Thomasyijun2026/pynq-av-tracker/docs/submission.md

# 评分项目与提交材料

依据已归档的 [AMD 赛道指南](https://fpgaceshi.oss-cn-shanghai.aliyuncs.com/profoss/upload/2026/08/31/8c7a809f-f0b8-42e4-996a-3a5f2f132288.pdf)自主选题部分 3.3，以及[作品上传说明](http://www.fpgachina.cn/notice-details.html?id=58)。指南归档 SHA256 为 `c6ad82acd4f7bdcd13bd412e232ed85d05f2a87dd5e2cdd04f9d219f88b569fc`。以下对应实际材料与评分项目，权重来自指南。

| 评分项目 | 权重 | 已准备内容与阅读入口 |
|---|---:|---|
| 创新性与应用价值 | 30% | 固定阵列感知、主动相机观察及已知参考初始化；[设计报告](../report/main.pdf)第 1、2、5 章与[系统结构](architecture.md) |
| 性能与资源优化效果 | 20% | PL/PS 分工、定点 FIR 流水化、相位计算优化对照、100 MHz 实现及资源时序报告；报告第 6 章与[性能资料](performance.md) |
| 功能正确性与设计完整性 | 20% | 实机视频、初始化成功记录、完整 RTL/PS/桌面源码和整数一致性检查；[演示内容](demo_recording.md)与[验证材料](validation.md) |
| 大模型协作与技能包 | 15% | 报告第 8、9 章、[协作记录](ai_collaboration.md)及[可复用技能包](../skill/README.md) |
| 文档质量与可复现性 | 15% | 原理、接口与硬件说明、工程恢复、构建步骤、文件摘要、MIT 与第三方许可；[复现入口](reproduce.md) |

## 已提交的三份成品

| 提交项 | 成品内容 |
|---|---|
| 演示视频 | 实机硬件介绍、桌面连接、人工初始化和声音引导相机的演示；MP4 / H.264，2 分 56.7 秒，52.27 MB |
| 技术文档 PDF | 31 页，覆盖原理、系统设计、硬件与软件、优化对照、实验结果、大模型协作、技能包及复现；9.58 MB，见[已提交报告](../report/main.pdf) |
| 完整源码 RAR | 14.39 MB，包含 231 个文件；独立解包、195 份工程源文件恢复、43 项整数参考及 64 项生命周期检查通过 |

三份文件的完整名称、大小与 SHA-256 见[提交材料索引](submitted_materials.md)。它们保持提交时内容；仓库说明更新后，源码 RAR 内的说明继续保留原样。

## 开源与配套材料

公开仓库为 `Thomasyijun2026/pynq-av-tracker`，原创代码采用 MIT。RTL、PS 与桌面源码位于 `source/`，测试向量、构建脚本和验证记录分别有对应入口。原始模块名通过 `manifests/source.json` 恢复。

演示视频与源码 RAR 通过参赛平台提交，本仓库记录其身份；报告 PDF 同时收录在 `report/main.pdf`。承诺授权书、海报和作品照片属于参赛平台的独立提交项，本页的三份成品核对不包含这些附件。
