Thomasyijun2026/pynq-av-tracker/docs/submitted_materials.md

# 已提交成品索引

本页对应已经提交的演示视频、技术文档和完整源码 RAR。三份文件按提交时内容冻结；仓库首页和补充说明独立维护，程序源码保持原样。

## 文件身份

| 成品 | 文件名 | 字节数 |
|---|---|---:|
| 演示视频 | 基于PYNQ-Z2的声源定位与视觉跟随系统_作品演示.mp4 | 52,267,604 |
| 技术文档 | 《基于 PYNQ-Z2 的声源定位与视觉跟随系统》设计报告.pdf | 9,577,298 |
| 完整源码 | 基于PYNQ的声视主动追踪系统_完整源码.rar | 14,385,354 |

SHA-256：

- 演示视频：`152224e2a3f9b92de04e864be2fa3caecfbe6d6da3aff6772eec99f8a4f45fdf`
- 技术文档：`09fd8e2e0904f29d18b212dc91cfdc4d5f5d7ad80b14771ad5f54f542d042716`
- 完整源码：`c4ebf6ebd987f6c2c28c40305b97008a4b7d1c911cfa9ca440bd513375ed5842`

## 建议阅读顺序

- 先看演示视频，了解装置组成、初始化和相机朝向变化；[演示内容](demo_recording.md)提供过程索引。
- 再看[技术报告](../report/main.pdf)：第 1、2、5 章说明目标与初始化方法，第 3、4 章说明 PL/PS 分工与算法，第 6 章给出优化和资源时序，第 7 章展示实测，第 8、9 章说明协作与技能包，附录给出接口与复现方法。
- 最后通过源码 RAR 或本仓库的[复现说明](reproduce.md)恢复工程、检查源文件与重跑测试。RAR 已完成独立解包和文件级校验，并通过 43 项整数参考与 64 项运行生命周期检查。

上述记录对应本页摘要标识的成品。原始验证数据和调试批次继续保存在[验证入口](validation.md)中，测试批次之间分别记录；展示文档更新不会改写这些记录。

## 许可

公开仓库的原创源码采用 [MIT](../LICENSE)。第三方代码及工具许可单列在[第三方说明](third_party.md)。已提交报告保留原文，本仓库的实际许可由 `LICENSE` 确定。
