Thomasyijun2026/pynq-av-tracker/validation/materials/initialization_records.csv

session | request_id | sequence | action | status | total_seconds | cleanup_verified | reason_category | source_id
session_B | ui_1793778394284_6ed8f0be | 1 | initialize | INITIALIZATION_REJECTED | 15.7980650720001 | True | SCREEN_NOT_FOUND | S1
session_B | ui_1793778439002_84727a12 | 2 | initialize | RELATIVE_TARGET_CONFIRMED | 43.90765636600008 | True |  | S7
session_A | ui_1793779146720_bdaa8e16 | 1 | initialize | INITIALIZATION_REJECTED | 41.370130856 | True | AUDIO_REFERENCE_REJECTED | S3
session_A | ui_1793779194005_c66174dc | 2 | initialize | RELATIVE_TARGET_CONFIRMED | 39.062433763 | True |  | S3
session_A | ui_1793779381276_d62e0b2d | 20 | initialize | INITIALIZATION_REJECTED | 28.89297830800001 | True | STATIC_VISUAL_MODEL_REJECTED | S4
session_A | ui_1793779415342_5df36497 | 21 | initialize | RELATIVE_TARGET_CONFIRMED | 44.35287299799995 | True |  | S8
session_A | ui_1793779543464_b0b11086 | 31 | initialize | RELATIVE_TARGET_CONFIRMED | 46.404588607999926 | True |  | S8
session_A | ui_1793780359812_51714cee | 117 | initialize | RELATIVE_TARGET_CONFIRMED | 41.84338274300012 | True |  | S8
session_A | ui_1793780539784_98df1130 | 133 | initialize | RELATIVE_TARGET_CONFIRMED | 43.50091960999998 | True |  | S8
session_A | ui_1793780795257_f9b87ca1 | 158 | initialize | INITIALIZATION_REJECTED | 33.87497050899992 | True | ACTUATOR_PROTECTION | S8
session_A | ui_1793780836292_30e9c1bc | 159 | initialize | INITIALIZATION_REJECTED | 39.202294648999896 | True | AUDIO_REFERENCE_REJECTED | S8
session_A | ui_1793780892419_86b76f78 | 160 | initialize | INITIALIZATION_REJECTED | 38.332203819999904 | True | AUDIO_REFERENCE_REJECTED | S8
