Thomasyijun2026/pynq-av-tracker/source/hardware/abi5/component_coordinates_v20.csv

reference | native_x_mm | native_y_mm | from_left_edge_mm | from_bottom_edge_mm | rotation_deg | layer | footprint
C1 | -7.999999 | 13.499998 | 10.500001 | 26.999998 | 0 | TOP | 87ca9d672aa2a90f
C2 | 11.2 | 53.649999 | 29.7 | 67.149999 | 90 | TOP | 87ca9d672aa2a90f
C3 | 43.2 | 53.649999 | 61.7 | 67.149999 | 90 | TOP | 87ca9d672aa2a90f
C4 | 75.199999 | 53.649999 | 93.699999 | 67.149999 | 90 | TOP | 87ca9d672aa2a90f
C5 | 107.200001 | 53.649999 | 125.700001 | 67.149999 | 90 | TOP | 87ca9d672aa2a90f
C6 | 11.2 | 13.650001 | 29.7 | 27.150001 | 90 | TOP | 87ca9d672aa2a90f
C7 | 43.2 | 13.650001 | 61.7 | 27.150001 | 90 | TOP | 87ca9d672aa2a90f
C8 | 75.199999 | 13.650001 | 93.699999 | 27.150001 | 90 | TOP | 87ca9d672aa2a90f
C9 | 107.200001 | 13.650001 | 125.700001 | 27.150001 | 90 | TOP | 87ca9d672aa2a90f
J1 | -9.499999 | 22.000002 | 9.000001 | 35.500002 | 0 | TOP | 0d0279508bada4d3
J2 | 2.000001 | 49.999999 | 20.500001 | 63.499999 | 0 | TOP | b306065b27b40484
J3 | 34.004999 | 50.036999 | 52.504999 | 63.536999 | 0 | TOP | b306065b27b40484
J4 | 66.0 | 49.999999 | 84.5 | 63.499999 | 0 | TOP | b306065b27b40484
J5 | 98.01 | 50.036999 | 116.51 | 63.536999 | 0 | TOP | b306065b27b40484
J6 | 2.000001 | 10.0 | 20.500001 | 23.5 | 0 | TOP | b306065b27b40484
J7 | 33.999998 | 10.0 | 52.499998 | 23.5 | 0 | TOP | b306065b27b40484
J8 | 66.0 | 10.0 | 84.5 | 23.5 | 0 | TOP | b306065b27b40484
J9 | 98.0 | 10.0 | 116.5 | 23.5 | 0 | TOP | b306065b27b40484
R1 | 1.5 | 24.800001 | 20.0 | 38.300001 | 0 | TOP | 87ca9d672aa2a90f
R2 | 1.5 | 21.000001 | 20.0 | 34.500001 | 0 | TOP | 87ca9d672aa2a90f
R3 | -7.999999 | 16.800002 | 10.500001 | 30.300002 | 0 | TOP | 87ca9d672aa2a90f
R11 | 12.000001 | -2.999999 | 30.500001 | 10.500001 | 0 | TOP | 87ca9d672aa2a90f
R12 | 33.999998 | -2.6 | 52.499998 | 10.9 | 0 | TOP | 87ca9d672aa2a90f
R13 | 43.999998 | -2.6 | 62.499998 | 10.9 | 0 | TOP | 87ca9d672aa2a90f
R14 | 66.0 | -2.6 | 84.5 | 10.9 | 0 | TOP | 87ca9d672aa2a90f
R21 | 4.540001 | 59.999999 | 23.040001 | 73.499999 | 90 | TOP | 87ca9d672aa2a90f
R22 | 36.539998 | 59.999999 | 55.039998 | 73.499999 | 90 | TOP | 87ca9d672aa2a90f
R23 | 68.54 | 59.999999 | 87.04 | 73.499999 | 90 | TOP | 87ca9d672aa2a90f
R24 | 100.54 | 59.999999 | 119.04 | 73.499999 | 90 | TOP | 87ca9d672aa2a90f
R25 | 5.248001 | 20.634998 | 23.748001 | 34.134998 | 90 | TOP | 87ca9d672aa2a90f
R26 | 36.539998 | 19.999998 | 55.039998 | 33.499998 | 90 | TOP | 87ca9d672aa2a90f
R27 | 68.54 | 19.999998 | 87.04 | 33.499998 | 90 | TOP | 87ca9d672aa2a90f
R28 | 100.54 | 19.999998 | 119.04 | 33.499998 | 90 | TOP | 87ca9d672aa2a90f
TP1 | -10.999998 | 0.0 | 7.500002 | 13.5 | 0 | TOP | 183806331354c27b
TP2 | -6.999999 | 0.0 | 11.500001 | 13.5 | 0 | TOP | 183806331354c27b
TP3 | -1.999999 | 0.0 | 16.500001 | 13.5 | 0 | TOP | 183806331354c27b
TP4 | 3.000002 | 0.0 | 21.500002 | 13.5 | 0 | TOP | 183806331354c27b
TP5 | 16.000001 | 0.0 | 34.500001 | 13.5 | 0 | TOP | 183806331354c27b
TP6 | 37.999998 | 0.0 | 56.499998 | 13.5 | 0 | TOP | 183806331354c27b
TP7 | 47.999998 | 0.0 | 66.499998 | 13.5 | 0 | TOP | 183806331354c27b
TP8 | 70.0 | 0.0 | 88.5 | 13.5 | 0 | TOP | 183806331354c27b
TP9 | 9.0 | 58.999999 | 27.5 | 72.499999 | 0 | TOP | 183806331354c27b
TP10 | 40.999999 | 58.999999 | 59.499999 | 72.499999 | 0 | TOP | 183806331354c27b
TP11 | 73.000001 | 59.253999 | 91.500001 | 72.753999 | 0 | TOP | 183806331354c27b
TP12 | 105.000001 | 58.999999 | 123.500001 | 72.499999 | 0 | TOP | 183806331354c27b
TP13 | 9.0 | 19.0 | 27.5 | 32.5 | 0 | TOP | 183806331354c27b
TP14 | 40.999999 | 19.0 | 59.499999 | 32.5 | 0 | TOP | 183806331354c27b
TP15 | 73.000001 | 19.0 | 91.500001 | 32.5 | 0 | TOP | 183806331354c27b
TP16 | 105.000001 | 19.0 | 123.500001 | 32.5 | 0 | TOP | 183806331354c27b
