Thomasyijun2026/pynq-av-tracker/docs/request_results.md

# 已保存实机请求统计

从同一冻结运行程序的 8 份历史快照提取，以 boot、进程启动身份和请求 ID 去重，共保存 98 个不同请求。快照历史长度有限，序号存在间隙；以下不是按固定实验条件连续采集的通过率试验。数据见 [统计 JSON](../validation/materials/request_statistics.json)、[初始化 CSV](../validation/materials/initialization_records.csv)、[来源摘要](../validation/materials/provenance.json)。

## 初始化

12 次中，6 次成功、6 次拒绝；12 次均有清理完成记录。两次启动会话分别保存 1 成功 / 1 拒绝与 5 成功 / 5 拒绝。一次成功不会覆盖随后失败。

| 会话 | 请求序号 | 结果 | 全过程 / 秒 | 拒绝原因 |
|---|---:|---|---:|---|
| session_B | 1 | 拒绝 | 15.798 | 未找到屏幕标识 |
| session_B | 2 | 成功 | 43.908 | — |
| session_A | 1 | 拒绝 | 41.370 | 声学参考未通过 |
| session_A | 2 | 成功 | 39.062 | — |
| session_A | 20 | 拒绝 | 28.893 | 静止视觉模型未通过 |
| session_A | 21 | 成功 | 44.353 | — |
| session_A | 31 | 成功 | 46.405 | — |
| session_A | 117 | 成功 | 41.843 | — |
| session_A | 133 | 成功 | 43.501 | — |
| session_A | 158 | 拒绝 | 33.875 | 执行器保护触发 |
| session_A | 159 | 拒绝 | 39.202 | 声学参考未通过 |
| session_A | 160 | 拒绝 | 38.332 | 声学参考未通过 |

成功记录耗时中位数 43.704 秒、范围 39.062～46.405 秒。拒绝保留了屏幕搜索、静止视觉模型、声学参考及执行器保护原因。这里没有已知角度真值，不能计算绝对角度误差。

## 后续声音观察

86 份观察请求中，38 份记录完成、47 份拒绝、1 份最后保存状态仍为运行中，未获得它的终结快照。记录完成仅说明本次方向观察流程形成结果，不等于独立声源身份或物理准确性已经确认。

两会话之间不复用坐标映射。没有把最后保存状态为运行中的请求补写成成功，也没有为整理材料向设备补发请求。
