Thomasyijun2026/pynq-av-tracker/docs/validation.md

# 验证材料与范围

本页将历史硬件证据、软件回归和本次发布校验分开。未经本轮重测的数据仍标为历史记录。

| 项目 | 已保存结果 | 文件入口 |
|---|---|---|
| ABI5 实现 | 66 项审查通过；setup +0.287 ns，hold +0.035 ns | [实现审查](../validation/implementation/review.json) |
| 资源 | LUT 14822、FF 11930、BRAM 1.5、DSP 2 | [资源报告](../validation/implementation/utilization.rpt) |
| 时钟与约束 | 100 MHz；保留 DRC、CDC、未约束路径检查 | [时序摘要](../validation/implementation/timing_summary.rpt) |
| RTL 仿真 | 历史相关器 14598 项、I2S/AXI 731932 项通过 | 复现入口 `reproduce.py simulate` 与源码自检标志 |
| 保存 PCM | 202 完整统计、808 子窗统计、6/24 峰值、guard 逐项比对 | [音频记录](../validation/audio_reference.json)，包内独立整数参考和原始输入 |
| 本安装初始化 | 保存了整圈搜索、静止标识确认、相对坐标建立的成功结果 | [结果节选与原来源摘要](../validation/initialization_excerpt.json) |
| 发布冻结 | 文件摘要、语法、文档链接、源码恢复及离线重跑 | [发布验收](../validation/release_checks.json) |

2026-11-03 的同一固定宽带声两段方向为 49.613391° 和 49.592268°，差约 0.021124°。这是该安装、该声源的批内重复性，不是绝对角度误差。相同批次背景和语音均出现方向一致性拒绝，结果已保留。两个不同音频文件从同一台电脑扬声器播放，也仍是一个物理声源。

2026-11-04 新 boot 的一次 UI 初始化成功记录为约 39.062434 秒，旧 boot 另有约 43.907656 秒记录。只将它们作为单次历史成功，不声称所有触发均成功或有固定耗时保证。用户随后选择冻结现有版本，发布过程没有再次转动、播放或采音。

## 报告所用补充数据

[请求统计](request_results.md) 汇总历史初始化与声音观察记录。[性能资料](performance.md) 提供六组同输入组件耗时对照、FPGA 资源和时序。[报告数据与来源](../validation/materials/) 保存公开节选和原始记录摘要。

## 当前结论

已有实机记录支持板端独立完成声音统计、标识检测、相对坐标初始化和声音驱动相机视野更新；桌面与板端直接通信。发布基线仍会拒绝未满足质量条件的输入，且保存了初始化失败记录。当前全套实机通过率、绝对角度精度、多个独立声源、物理按钮和新 SD 卡部署未形成完整验收。一般模板相似度也不等于目标识别概率。

本次发布程序只完成离线复核；未改变已安装服务、机械参数或音频门限。包内实现报告为此前正式构建产物，源码清单记录来源与 SHA。文件校验通过只说明交付内容一致，不替代上述物理验证。
