Thomasyijun2026/pynq-av-tracker/validation/implementation/timing_metrics.tsv

setup_slack_ns | 0.287
hold_slack_ns | 0.035
clock_count | 2
