Thomasyijun2026/pynq-av-tracker/(commit log)

2026-11-04 Publish frozen PYNQ AV tracker source and reproducible evidence
    [component_coordinates_v20.csv, timing_metrics.tsv]
2026-11-04 Align AMD competition repository layout and evidence
    [initialization_records.csv]
